bee-0207/open-canvas/assets/markers.pdf

## Open Canvas corner markers - ArUco DICT_4X4_50, 50 mm, 10 mm border

ID 0 - TOP-LEFT corner | ID 1 - TOP-RIGHT corner
ID 3 - BOTTOM-LEFT corner | ID 2 - BOTTOM-RIGHT corner

This bar must measure exactly 10.0 cm. If not, reprint at 100% / Actual size.

1. Cut along the dashed lines (keep the white border; the detector needs it).
2. Place each tile diagonally outside its corner of the picture, with the tile’s
inner corner touching the picture’s corner. Tile edges parallel to picture edges.
3. Rotation of the marker itself doesn’t matter. Keep tiles flat; matte paper if possible.
4. Then the marker-to-picture gap is 10 mm: pass --gap-mm 10 to the test script.
