bee-0207/open-canvas/content/overview.txt

Welcome to Open Canvas. This is a landscape at sunset, wider than it is tall. The top half is sky, deep blue above and glowing peach near the hills. Two small clouds float near the top. On the right, an orange sun sets behind a large hill. Blue-green hills cross the middle. A yellow-green field fills the bottom, with a sandy path winding up the center. A tall tree stands on the left. Touch anywhere to explore. To hear about a spot, rest your finger on it and keep still.
