bee-0207/open-canvas/assets/print_pack.pdf

# Sunset Hills

## the Open Canvas team

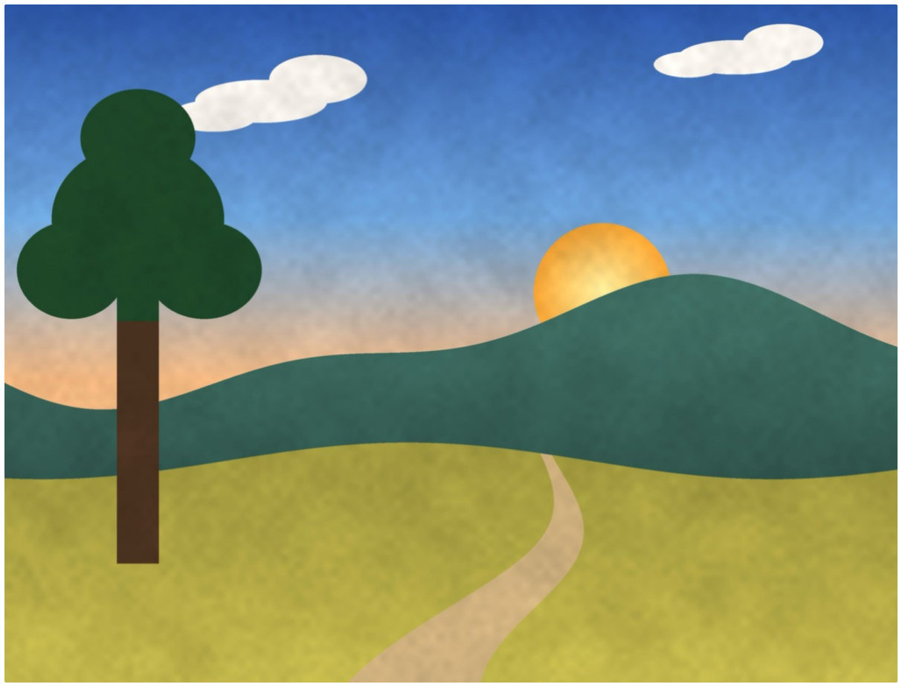
[picture p9: figure]

Lay flat under the camera with all four corner squares visible.

Open Canvas print pack, page 1 of 4. Print at Actual size, or Fit to page on bigger paper.

cut

# The Great Wave off Kanagawa

## Katsushika Hokusai

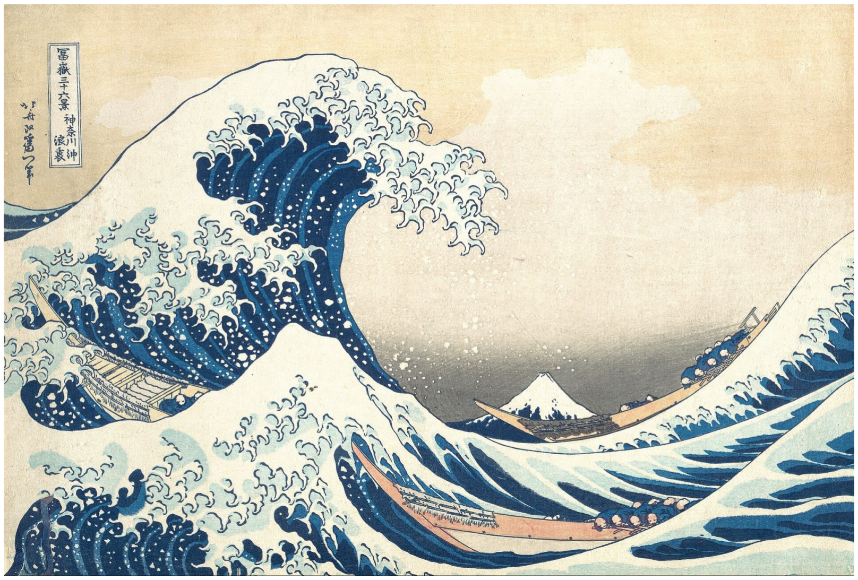
[picture p10: figure]

Lay flat under the camera with all four corner squares visible.

Open Canvas print pack, page 2 of 4. Print at Actual size, or Fit to page on bigger paper.

# The Starry Night

## Vincent van Gogh

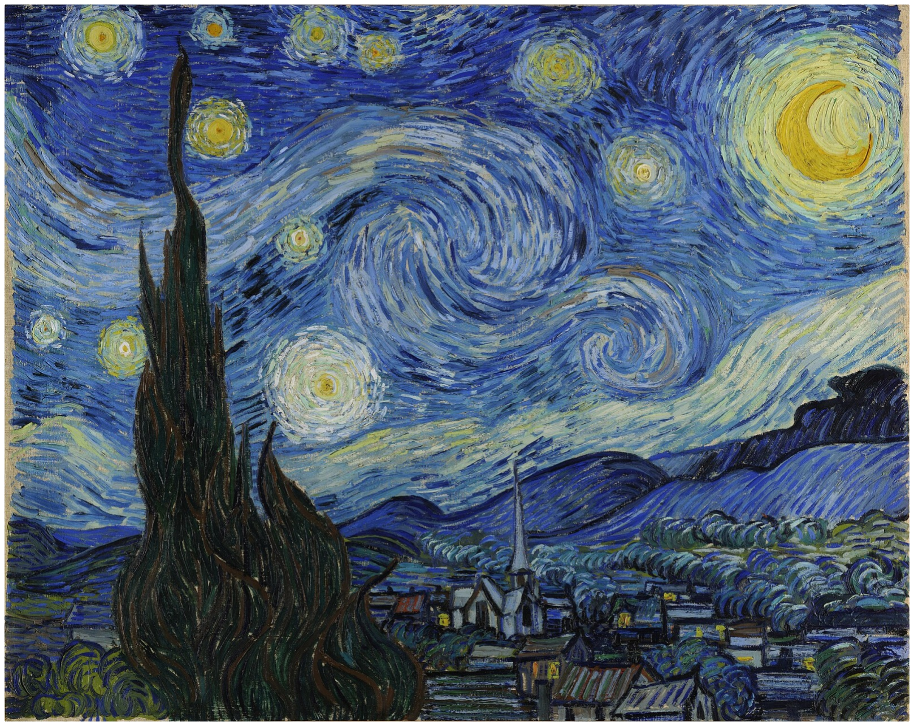
[picture p11: figure]

Lay flat under the camera with all four corner squares visible.

Open Canvas print pack, page 3 of 4. Print at Actual size, or Fit to page on bigger paper.

# Composition with Red, Blue and Yellow

## Piet Mondrian

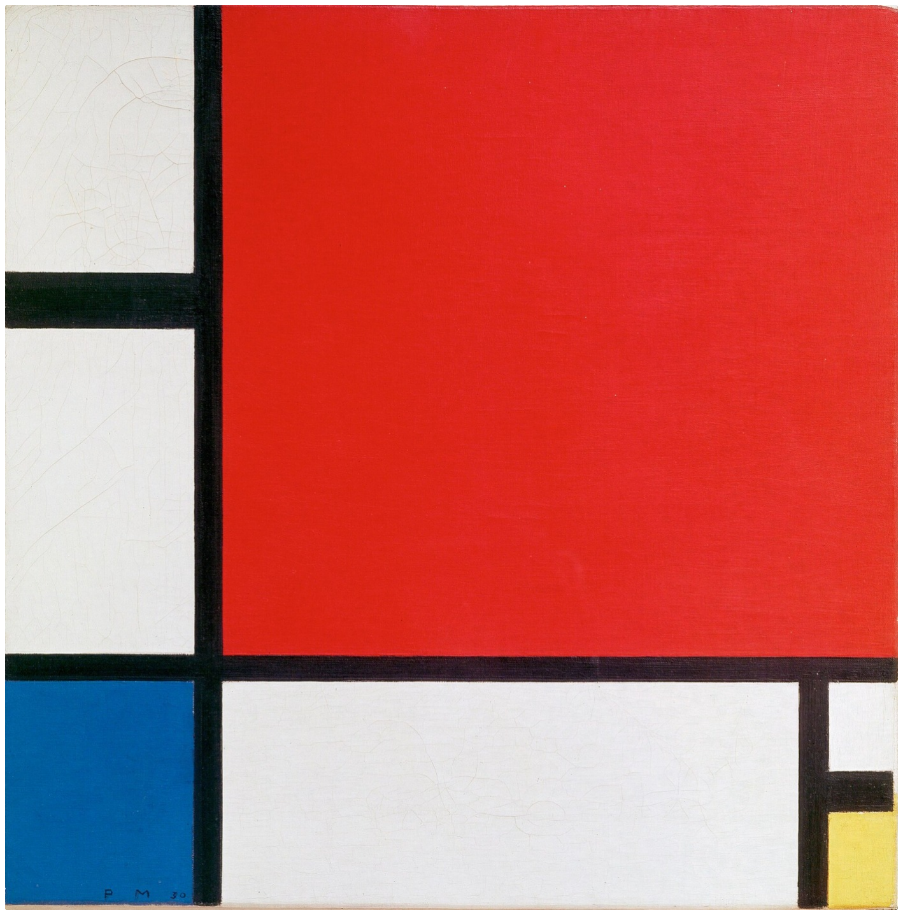
[picture p12: figure]

Lay flat under the camera with all four corner squares visible.

Open Canvas print pack, page 4 of 4. Print at Actual size, or Fit to page on bigger paper.
