bee-0207/open-canvas/app/config.yaml

# Settings for app/main.py. Command-line flags override these (python -m app.main --help).

camera:
  index: 0              # Acer was 0 with the iPhone connected; numbering can change, check if wrong view
  width: 1280
  height: 720

print:                  # the picture's size between the markers, in mm (see tools/test_markers)
  width_mm: 279.4       # Letter landscape stand-in; A3 landscape = 420 x 297
  height_mm: 215.9
  marker_mm: 50.0
  gap_mm: 10.0

serial:
  port: null            # e.g. /dev/cu.usbserial-0001 or /dev/cu.usbmodem101; null = no board (motor simulated)

tuning:                 # the knobs to adjust during user testing (CLAUDE.md section 11)
  tip_offset: 0.0       # pull the fingertip back toward the finger pad: 0 = landmark 8 as is,
                        # 0.5 = halfway to the next joint (landmark 7)
  smoothing: 0.5        # EMA weight of the NEW position each frame: 1 = no smoothing, lower = steadier but laggier
  edge_frames: 2        # consecutive frames in/out of the edge band before the motor switches (hysteresis)
  switch_frames: 8     # frames in a row a new painting's markers must be seen before switching to it
  prompt_after_s: 5     # no painting recognized this long after start -> say "place a painting under the camera"
  welcome_idle_s: 30    # no finger on the painting this long -> the next touch plays the overview (welcome)
  hold_s: 0.30          # unused: the describe button was dropped Oct 24 (hover-to-speak instead)
  min_confidence: 0.5   # MediaPipe hand detection/tracking confidence
  off_margin: 0.02      # finger counts as on the painting up to this far outside [0, 1]
