bee-0207/open-canvas/(commit log)

2026-10-22 Add setup guide and pin Python dependencies
    - SETUP.md: step-by-step Python 3.11 venv setup for macOS, Windows, Linux,
    with a verification check and troubleshooting table
    - requirements.txt: pin exact versions; use opencv-contrib-python only
    (mediapipe depends on it and conflicts with opencv-python)
    - CLAUDE.md: add "Start here" section for teammates' Claude Code sessions,
    fix OpenCV package in software stack, generalize working-style section
2026-10-24 Add audio engine, color map, fake inputs and voice tool
    - app/audio/engine.py: AudioEngine with the section 7 API (update, describe),
    four-layer mixing, smoothed gains, equal-power panning, region dwell,
    ducking + chime, pre-rendered voice fallback for describe.
    - app/audio/color_map.py: HSL -> instrument weights and register mix
    (adds woodwind for green; open question for the team).
    - tools/fake_inputs.py: drives the engine without camera or ESP32
    (scripted finger path at 30 Hz with jitter and dropout; live or render).
    - tools/make_voices_elevenlabs.py: pre-renders overview + region
    descriptions to assets/sounds/voice/ (key from gitignored .env).
2026-10-24 Replace placeholder object sounds and chime, shorten overview
    - tools/make_sfx_elevenlabs.py: generates the six object loops and the
    chime with ElevenLabs Sound Effects (prompts in the file).
    - New loops: birds, cicadas (softened above 4 kHz, -6 dB trim on the sun),
    wind, crickets, leaves, and footsteps for the path (was crickets).
    - Overview rewritten for the team painting: 49 s -> 31 s.
    - Measured balance: areas within 2 dB of each other; voice ~11 dB above
    the ducked bed.
2026-10-24 Note Acer webcam camera index
2026-10-24 Add visual mouse demo for the audio engine
    tools/mouse_demo.py draws the painting in an OpenCV window (no new
    packages) and drives the engine with the mouse at 30 Hz: hold left
    button = arcade button (0.3 s), SPACE describe, O overview, R region
    overlay. --tour plays the fake_inputs path with visuals.
2026-10-24 Reconnect webcam on dropped frames in marker test
2026-10-24 Add MediaPipe fingertip tracking and live hand test
2026-10-24 Add main loop with lookup, edge motor hysteresis and serial link
2026-10-24 Skip missing edges.png quietly and log main loop milestone
    [lookup.py]
2026-10-24 Add hover-to-speak and drop the chime
    Resting the finger on one region for 2 s (HOVER_TIME) now speaks that
    region's description, with the music ducked and no chime. It runs inside
    update(), so the main loop needs no change; the section 7 API is the
    same and describe() on the button still works (now speech only,
    USE_CHIME = False).
    - Uses the debounced region, so boundary jitter doesn't restart the timer.
    - Same region is not repeated within 20 s (HOVER_REPEAT).
    - Waits for the overview to finish; a new description replaces the old.
    - Optional crop_fn=(u, v) -> crop feeds the AI describer on hover.
    - mouse_demo.py draws a ring that fills over the 2 s.
2026-10-24 Add Arduino Uno firmware for motor and button
2026-10-24 Add hardware build guide and schematic for the Uno motor and button
2026-10-24 Point teammates to the hardware guide and current status in CLAUDE.md
2026-10-25 Require a still finger for 2.5 s before hover describes a region
    Gliding through a large region (field, hills) used to trigger its
    description after 2 s. The hover timer now also restarts when the finger
    moves more than HOVER_RADIUS (0.04 in u, v) from where it stopped.
    Also log button presses in the main loop.
2026-10-25 Drop the describe button from the plan
    Resting the finger still for ~2.5 s (hover-to-speak) replaces it. The
    motor works live with the Uno. Button code in the firmware and serial
    link stays but is unused; D2 is left unwired.
    [config.yaml]
2026-10-25 Speak the overview to each new visitor and add a no-typing launcher
    The overview plays on the first touch after 30 s with no finger on the
    painting, so a blind visitor never needs the keyboard. The launcher
    (double-click or Siri Shortcut) finds the motor board port itself.
    Overview script updated for hover-to-speak; overview.wav still needs
    re-rendering with the ElevenLabs key.
    [config.yaml, main.py]
2026-10-25 Fix launcher missing the Uno and lower the music 3 dB
    zsh aborts a line when a glob matches nothing, so the missing
    /dev/cu.usbserial* pattern hid /dev/cu.usbmodem* and the launcher ran
    with the motor simulated. Use the (N) glob qualifier instead.
    MUSIC_LEVEL 1.0 -> 0.7 so voice and object sounds sit above the music.
2026-10-25 Add a painting library, print pack and Mac app
    Each printed page carries its own four ArUco markers (content/library.yaml),
    so the main loop recognizes which painting is under the camera, switches
    to it and speaks its overview. No menu for a blind user: swap the page.
    - Three public-domain paintings with region maps, descriptions, sounds and
    macOS-voice clips: The Great Wave, The Starry Night, Mondrian 1930
    - tools/make_print_pack.py: one Letter page per painting, markers on the page
    - tools/make_mac_app.py: builds Open Canvas.app (no Terminal window)
    - Camera open waits for the first-run permission prompt instead of quitting
    - Sunset Hills content and its taped board (markers 0-3) unchan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
    [config.yaml, library.py, main.py]
2026-10-25 Add the submission slide deck (PDF and PowerPoint)
2026-10-25 Add a license and build log, remove the unused ESP32 folder
    The demo runs on the Arduino Uno, so the empty ESP32 firmware folder is
    gone and the docs that pointed to it now name the Uno. PROGRESS.md was a
    working log with stale next steps; it is now a build log with the
    timeline, known limits and next ideas. Code is MIT licensed.
